TruongTanNghia/coding-robot/xe_ne_vat_can/Final1.docx

Linh kiện:

Xe

Phần cứng

- 2 động cơ 12v35rpm có encoder: điều khiển 2 bánh xích để di chuyển xe

- 1 lidar C1M1: SLAM, phát hiện vật cản, dùng để di chuyển tự động

- Pi 5 (gọi tắt Pi5X): bộ xử lý trung tâm xe. Xử lý toàn bộ xe, điều khiển và thuật toán

- Arduino Mega 2560: vi điều khiển điều khiển động cơ 12v35rpm

- L298N: mạch cầu H, điều khiển thông số xe

- Nguồn 5v-3A: cấp cho pi

- nguồn 12v: cấp cho L298N cho động cơ xe

- Màn hình: hiển thị giao diện

- (Option thêm nếu cần): MPU 6050: dùng cho xác định tọa độ

Phần mềm

- Ubuntu 24.04: ROS2-jazzy

- Đã cài nghiên cứu trước đó: SLAM-Toolbox, Rviz2

- (Option thêm đã làm những lỗi): EKF, CALIBRATE, GAZEBO, PID

Cánh tay:

Phần cứng

- cơ khí cánh tay 3 bậc tự do và 1 tay gắp kẹp

- 3 động cơ bước stepmotor để điều khiển 3 bậc tự do

- 1 động cơ servo điều khiển tay gắp

- 3 motor driver đỏ

- 1 shield

- 1 Ardunio Uno: vi điều khiển toàn bộ cánh tay

- 1 Camera trên tay gắp của cánh tay

- 1 Pi 5 (gọi tắt Pi5T): bộ xử lý trung tâm của cánh tay và nhận diện hình ảnh, AI

# I. QUY TRÌNH QUÉT BẢN ĐỒ TỰ ĐỘNG (SLAM MAPPING)

Trước tiên, kiểm tra kết nối và nguồn của Pi5X, Lidar C1M1, Arduino Mega, L298N và hai động cơ. Trên Pi5X (Ubuntu 24.04 + ROS2 Jazzy) khởi động các node cơ bản: driver Lidar, odom từ encoder, cầu nối motor và slam ở chế độ online-async.

Đặt xe tại 1 vị trí và đặt đó là điểm gốc rồi bấm “Bắt đầu quét” trên Web. Việc quét chạy ở chế độ hybrid: mặc định Auto Explore (quét map tự động), Pi5X dùng frontier-based exploration để tự tìm các biên giới giữa vùng đã biết và chưa biết rồi lần lượt đặt goal đi tới, tự vẽ bản đồ. Trên Web luôn có nút Teleop để người dùng can thiệp bằng tay khi cần chủ động can thiệp, sau đó có thể bấm lại Auto để trả về cho xe tự chạy.

Khi bản đồ đã quét toàn khu vực, bấm “Lưu bản đồ” -> Pi5X xuất ra map.yaml + map.pgm, Web hiển thị lại bản đồ 2D làm nền cho bước lập kế hoạch đường chạy. Các lần chạy sau, xe khởi động ở chế độ Localization và người dùng chỉ cần “Set Initial Pose” trên Web.

Trường hợp cần quét bản đồ mới, khi chuyển sang vườn khác, trên Web có nút “Quét bản đồ mới”. Bấm nút này hiện dialog xác nhận và cho nhập tên bản đồ (ví dụ farm_A_20261120); server sẽ backup bản đồ hiện tại vào /maps/archive/ rồi đổi state-machine sang MAPPING, đồng thời hủy mọi mission đang chờ trong hàng đợi. Pi5X tự shutdown node AMCL/Localization và khởi động lại slam ở chế độ mapping với file .posegraph mới. Sau đó lặp lại quy trình quét như ban đầu (Auto Explore + Teleop khi cần), rồi “Lưu bản đồ” — bản đồ mới sẽ được lưu vào /maps/{tên_mới}/ gồm map.yaml, map.pgm và .posegraph. Ngoài ra Web có tùy chọn “Cập nhật bản đồ hiện tại” khi chỉ muốn bổ sung một khu chưa quét: server nạp lại .posegraph cũ để slam tiếp tục mở rộng bản đồ mà không cần vẽ lại từ đầu, xong bấm “Lưu” để ghi đè bản đồ hiện tại (kèm backup tự động). Khi map mới đã lưu, người dùng chọn bản đồ nào để làm việc qua dropdown “Chọn bản đồ” trên Web — server đẩy đường dẫn xuống Pi5X, xe reload và trở lại chế độ Localization bình thường.

# II. QUY TRÌNH CẮT DÂU TỰ ĐỘNG

Hai Pi (Pi5X cho xe, Pi5T cho cánh tay) cùng kết nối Web Server. Pi5X nạp bản đồ và chạy localization; Pi5T bật camera và mô hình AI, cánh tay ở tư thế HOME. Web hiển thị READY khi tất cả module sẵn sàng.

Người dùng chọn các điểm A, B, C, D… trên Web rồi gửi kế hoạch. Pi5X đi theo waypoint bằng Nav2. Trong lúc đi, Pi5T liên tục nhận diện dâu; khi thấy trái chín trong tầm với, nó gửi STOP → xe dừng, cánh tay tính tọa độ 3D và điều khiển ba stepmotor + servo để hái, xong thì gửi RESUME.

Đến waypoint cuối, Pi5X báo DONE, Web ghi log số dâu đã hái và cho phép “Về HOME”. Có ba lớp an toàn: mất Wi-Fi >3s xe tự dừng, Lidar phát hiện vật cản thì Nav2 tự né, và nút E-STOP đỏ trên Web luôn dừng cả xe lẫn cánh tay.

Sau khi E-STOP, hệ thống chuyển sang trạng thái khóa. Server hủy mission trong Nav2. Khi bấm Reset E-STOP, xe chạy lại được, sau đó có hai lựa chọn: “Tiếp tục mission” (server còn nhớ waypoint dang dở, xe re-localize bằng AMCL rồi Nav2 replan từ vị trí hiện tại tới waypoint kế tiếp), hoặc “Hủy mission” để quay lại màn hình planning chọn A, B, C, D… lại từ đầu.

# III. LẬP KẾ HOẠCH ĐƯỜNG CHẠY QUA WEB SERVER

Web Server hiển thị bản đồ 2D dưới dạng canvas. Người dùng bấm chuột để đặt điểm mới, mỗi điểm tự đánh nhãn A, B, C, D… kèm tọa độ (x, y) và hướng yaw (mặc định theo hướng đi từ điểm trước), só thể kéo-thả để tinh chỉnh vị trí.

Bên phải bản đồ là danh sách các điểm theo thứ tự đi. Có thể xóa điểm chọn sai hoặc “Xóa toàn bộ”. Sau khi xóa, các nhãn tự đánh số lại liên tục. Trước khi gửi, Web vẽ đường nối, ước lượng quãng đường và kiểm tra hợp lệ (điểm nằm trong vùng trống, không trùng vật cản). Bấm “Gửi kế hoạch” đẩy danh sách waypoint xuống Pi5X qua POST /api/mission hoặc WebSocket, Pi5X ACK lại và Web chuyển sang trạng thái “Đang chạy”.

# IV. GIAO TIẾP XE ↔ CÁNH TAY QUA SERVER

1) Kiến trúc kết nối

- Pi5X (xe) và Pi5T (cánh tay) đều là client, kết nối vào Web Server qua WebSocket.

- Server đóng vai trò trung gian: nhận tín hiệu từ một Pi rồi chuyển tiếp sang Pi kia, đồng thời đẩy realtime lên giao diện Web cho người dùng thấy.

- Hai Pi KHÔNG nói chuyện trực tiếp với nhau, mọi thứ đi qua server để dễ log, dễ debug và Web luôn biết trạng thái.

2) Các tín hiệu chính

Từ cánh tay (Pi5T) gửi lên:

- STOP — thấy dâu chín, yêu cầu xe dừng ngay.

- RESUME — đã hái xong, xe đi tiếp.

- ARM_BUSY / ARM_IDLE — cánh tay đang hái / đang rảnh.

- ARM_ERROR — cánh tay lỗi (kẹt, mất bước, quá nhiệt driver…).

Từ xe (Pi5X) gửi lên:

- CAR_STOPPED {pose} — xe đã dừng, kèm vị trí hiện tại (x, y, yaw).

- CAR_MOVING — xe đang chạy.

- WP_REACHED — vừa tới một waypoint.

- MISSION_DONE — đã đi hết toàn bộ kế hoạch.

Từ Web UI (người dùng bấm nút):

- E_STOP — dừng khẩn cấp toàn hệ.

- E_STOP_RESET — mở khóa E-STOP sau khi đã kiểm tra an toàn.

- PAUSE / CONTINUE — tạm dừng / chạy tiếp.

- GO_HOME — về vị trí HOME.

- MISSION_RESUME {from_wp_id} — tiếp mission từ waypoint chỉ định.

- MISSION_CANCEL — hủy mission, về màn hình planning.

Giữa server và hai Pi (khi phục hồi sau E-STOP):

- READY_CHECK — server yêu cầu Pi tự kiểm tra module.

- READY_OK / READY_FAIL {module, reason} — Pi báo kết quả kiểm tra.

3) Luồng khi phát hiện dâu (6 bước)

- Bước 1: Pi5T nhận diện thấy dâu chín trong tầm với → gửi STOP lên server.

- Bước 2: Server chuyển STOP xuống Pi5X.

- Bước 3: Xe dừng bánh, gửi lại CAR_STOPPED kèm pose hiện tại.

- Bước 4: Pi5T tính inverse kinematics từ pose xe + tọa độ trái dâu → điều khiển 3 stepmotor + servo để hái.

- Bước 5: Hái xong, Pi5T gửi RESUME.

- Bước 6: Xe đi tiếp tới waypoint kế.

4) Cơ chế an toàn (option bỏ qua nếu ko làm kịp)

- Heartbeat 500ms — hai Pi ping server đều đặn; nếu server mất tín hiệu quá 2 giây thì tự phát E_STOP.

- ACK trong 200ms — mọi lệnh quan trọng phải có biên nhận trong 200ms, không thì gửi lại tối đa 3 lần rồi báo lỗi.

- Thứ tự ưu tiên tín hiệu (cao → thấp): E_STOP > STOP > PAUSE > RESUME. Lệnh cấp cao đè lệnh cấp thấp đang chờ xử lý.

- State-machine tổng do server giữ, các trạng thái: IDLE / MAPPING / PLANNING / RUNNING / ARM_PICKING / PAUSED / E_STOP / RECOVERING. Mỗi lần đổi trạng thái server broadcast cho tất cả client để UI và hai Pi luôn đồng bộ.

## Danh sách dây nối cụ thể (wire-by-wire)

Dưới đây là danh sách từng sợi dây, dạng “chân A trên thiết bị A ↔ chân B trên thiết bị B”. Nối theo đúng thứ tự này khớp hoàn toàn với code Arduino.

## A. Arduino Mega ↔ Encoder TRÁI (trên trục motor trái)

• Mega D2 ↔ Encoder TRÁI, chân A (OUT-A)

• Mega D3 ↔ Encoder TRÁI, chân B (OUT-B)

• Mega 5V ↔ Encoder TRÁI, chân Vcc

• Mega GND ↔ Encoder TRÁI, chân GND

## B. Arduino Mega ↔ Encoder PHẢI (trên trục motor phải)

• Mega D18 ↔ Encoder PHẢI, chân A (OUT-A)

• Mega D19 ↔ Encoder PHẢI, chân B (OUT-B)

• Mega 5V ↔ Encoder PHẢI, chân Vcc

• Mega GND ↔ Encoder PHẢI, chân GND

## C. Arduino Mega ↔ L298N (phía tín hiệu logic)

*Kênh A của L298N điều khiển motor PHẢI:

• Mega D5 ↔ L298N IN1

• Mega D9 ↔ L298N IN2

• Mega D12 ↔ L298N ENA (giữ HIGH để enable kênh A; tháo jumper ENA trên board L298N)

*Kênh B của L298N điều khiển motor TRÁI:

• Mega D10 ↔ L298N IN3

• Mega D6 ↔ L298N IN4

• Mega D13 ↔ L298N ENB (giữ HIGH để enable kênh B; tháo jumper ENB trên board L298N)

• Mega GND ↔ L298N GND (bắt buộc chung mass)

## D. L298N ↔ hai động cơ 12V-35RPM

• L298N OUT1 ↔ Motor PHẢI, cực +

• L298N OUT2 ↔ Motor PHẢI, cực −

• L298N OUT3 ↔ Motor TRÁI, cực +

• L298N OUT4 ↔ Motor TRÁI, cực −

Ghi chú: nếu bánh xe quay ngược hướng mong muốn, đảo hai đầu OUT1↔OUT2 (hoặc OUT3↔OUT4). Không cần sửa code.

## G. LiDAR C1M1 ↔ Pi5X

• LiDAR C1M1, cổng USB ↔ Pi5X, cổng USB-A

## H. ATMEGA ↔ Pi5X

• ATMega cổng USB ↔ Pi5X
