TruongTanNghia/coding-robot/(commit log)

2026-07-16 Initial commit: xe né vật cản (ROS2 + Arduino motor bridge)
2026-07-16 Sửa shutdown sạch cho 2 node + thêm TF tĩnh base_link->laser
    - base_bridge: thread serial thoát êm khi đóng cổng, join trước khi close,
    không gọi rclpy.shutdown() trùng
    - obstacle_avoider: chỉ publish lệnh dừng khi context còn sống
    - launch: thêm static_transform_publisher base_link->laser (cần cho SLAM/RViz2)
2026-07-16 Launch: thêm argument lidar_port để đổi cổng LiDAR từ dòng lệnh
2026-07-16 gitignore: bỏ qua build/install/log của ROS2 và sllidar_ros2 clone ngoài
2026-07-16 Launch: mặc định cổng LiDAR theo đường dẫn by-id cố định của C1
2026-07-16 Chỉnh tốc độ khớp motor 35rpm (max 0.12 m/s) + cổng LiDAR mặc định ttyUSB1
    PWM cho tốc độ cruise tăng từ ~60% lên ~85% -> bánh hết quay yếu
2026-07-16 Avoider: thêm min_valid_dist để lọc trụ chống của khung xe khỏi scan
    LiDAR gắn giữa 2 tầng khung nên luôn thấy 4 trụ chống ở khoảng cách gần
    -> xe tưởng có vật cản sát mặt và xoay né vô hạn. Bỏ qua mọi điểm gần
    hơn min_valid_dist (mặc định 0.25m, chỉnh được lúc chạy bằng ros2 param).
    [obstacle_avoider.py]
